vojinvukcevic/ohmsprint-energy-meter-pcb/bom/OhmSprint_V1_BOM.csv

Reference | Qty | Value | Exclude from BOM | Datasheet | MANUFACTURER | Manufacturer Product Number
C1,C4 | 2 | 100uF |  | https://www.digikey.com/en/products/detail/w%C3%BCrth-elektronik/860040573004/5727450 | Würth Elektronik | 860040573004
C2,C3,C21,C22,C25 | 5 | 1uF |  | https://www.digikey.com/en/products/detail/samsung-electro-mechanics/CL21B105KAFNNNE/3886724 | Samsung Electro-Mechanics | CL21B105KAFNNNE
C5,C6,C14,C15 | 4 | 33nF |  | https://www.digikey.com/en/products/detail/tdk/C2012C0G1H333J125AA/2732958 | TDK | C2012C0G1H333J125AA
C7,C9,C10,C12,C13,C16,C17,C18,C23,C27 | 10 | 0.1uF |  | https://www.digikey.com/en/products/detail/kemet/C0805C104K5RACTU/411169 | KEMET | C0805C104K5RACTU
C8,C19,C26 | 3 | 10uF |  | https://www.digikey.com/en/products/detail/samsung-electro-mechanics/CL21A106KOQNNNE/3886754 | Samsung Electro-Mechanics | CL21A106KOQNNNE
C11,C20 | 2 | 10nF |  | https://www.digikey.com/en/products/detail/kemet/C0805C103K5RACTU/411157 | KEMET | C0805C103K5RACTU
C24 | 1 | 220uF |  | https://www.digikey.com/en/products/detail/rubycon/25YXJ220M6-3X11/3563124 | Rubycon | 25YXJ220M6.3X11
D1 | 1 | 1N4007 |  | https://www.digikey.com/en/products/detail/mcc-micro-commercial-components/1n4007-tp/773644 | MCC (Micro Commercial Components) | 1N4007-TP
D2,D3,D4,D5 | 4 | LED |  | https://www.digikey.com/en/products/detail/xinglight/XL-2012UGC/25673312 | XINGLIGHT | XL-2012UGC
FB1 | 1 | 120R |  | https://www.digikey.com/en/products/detail/laird-signal-integrity-products/LI0805H121R-10/806621 | Laird-Signal Integrity Products | LI0805H121R-10
J1 | 1 | PJ-002AH-SMT-TR |  | https://www.digikey.com/en/products/detail/same-sky-formerly-cui-devices/PJ-002AH-SMT-TR/408452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 | Same Sky (Formerly CUI Devices) | PJ-002AH-SMT-TR
J2 | 1 | SJ-3523-SMT-TR |  | https://www.digikey.com/en/products/detail/same-sky-formerly-cui-devices/SJ-3523-SMT-TR/281297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 | Same Sky (Formerly CUI Devices) | SJ-3523-SMT-TR
J3 | 1 | USB4105-GF-A |  | https://www.digikey.com/en/products/detail/gct/USB4105-GF-A/11198441 | GCT | USB4105-GF-A
R1,R3 | 2 | 2R4 |  | https://www.digikey.com/en/products/detail/panasonic-industry/ERJ-6GEYJ2R4V/282163 | Panasonic Industry | ERJ-6GEYJ2R4V
R2,R4,R6,R7,R17 | 5 | 1K |  | https://www.digikey.com/en/products/detail/vishay-dale/CRCW08051K00FKEA/1175637 | Vishay Dale | CRCW08051K00FKEA
R8 | 1 | 25K |  | https://www.digikey.com/en/products/detail/te-connectivity-passive-product/CPF0805B25KE1/2385271 | TE Connectivity Passive Product | CPF0805B25KE1
R9 | 1 | 51R |  | https://www.digikey.com/en/products/detail/panasonic-industry/ERJ-P06F51R0V/9811850 | Panasonic Industry | ERJ-P06F51R0V
R10,R11 | 2 | 510R |  | https://www.digikey.com/en/products/detail/panasonic-industry/ERJ-3GEYJ511V/104634 | Panasonic Industry | ERJ-3GEYJ511V
R12,R16,R20,R21 | 4 | 10K |  | https://www.digikey.com/en/products/detail/yageo/RT0805BRD0710KL/1075550 | YAGEO | RT0805BRD0710KL
R13,R14 | 2 | 22R |  | https://www.digikey.com/en/products/detail/vishay-dale/CRCW080522R0FKEA/1175445 | Vishay Dale | CRCW080522R0FKEA
R15 | 1 | 1K5 |  | https://www.digikey.com/en/products/detail/yageo/RC0805FR-071K5L/727496 | YAGEO | RC0805FR-071K5L
R18,R19 | 2 | 5K1 |  | https://www.digikey.com/en/products/detail/koa-speer-electronics-inc/RK73B2ATTD512J/10236505 | KOA Speer Electronics, Inc. | RK73B2ATTD512J
SW1,SW2,SW3,SW4,SW5 | 5 | SW_Nidec_CAS-120A1 |  | https://www.digikey.com/en/products/detail/e-switch/EG1218/101726 | E-Switch | EG1218
U1 | 1 | ATM90E26-YU-R |  | https://www.digikey.com/en/products/detail/microchip-technology/ATM90E26-YU-R/4899918 | Microchip Technology | ATM90E26-YU-R
U2 | 1 | STM32F373CCTx |  | https://www.digikey.com/en/products/detail/stmicroelectronics/STM32F373CCT6/3648271 | STMicroelectronics | STM32F373CCT6
U3 | 1 | USBLC6-2SC6 |  | https://www.digikey.com/en/products/detail/stmicroelectronics/USBLC6-2SC6/1040559 | STMicroelectronics | USBLC6-2SC6
U4 | 1 | AP2213M-3.3TRG1 |  | https://www.digikey.com/en/products/detail/diodes-incorporated/AP2213M-3-3TRG1/5305740 | Diodes Incorporated | AP2213M-3.3TRG1
U5 | 1 | BM70BLES1FC2-0B03AA |  | https://www.digikey.com/en/products/detail/microchip-technology/BM70BLES1FC2-0B03AA/6623469 | Microchip Technology | BM70BLES1FC2-0B03AA
Y1 | 1 | 8.192MHz |  | https://www.digikey.com/en/products/detail/txc-corporation/AA-8-192MAGE-T/3454735 | TXC CORPORATION | AA-8.192MAGE-T
