vojinvukcevic/ohmsprint-energy-meter-pcb/kicad/3D_models/CL21A106KOQNNNE.step

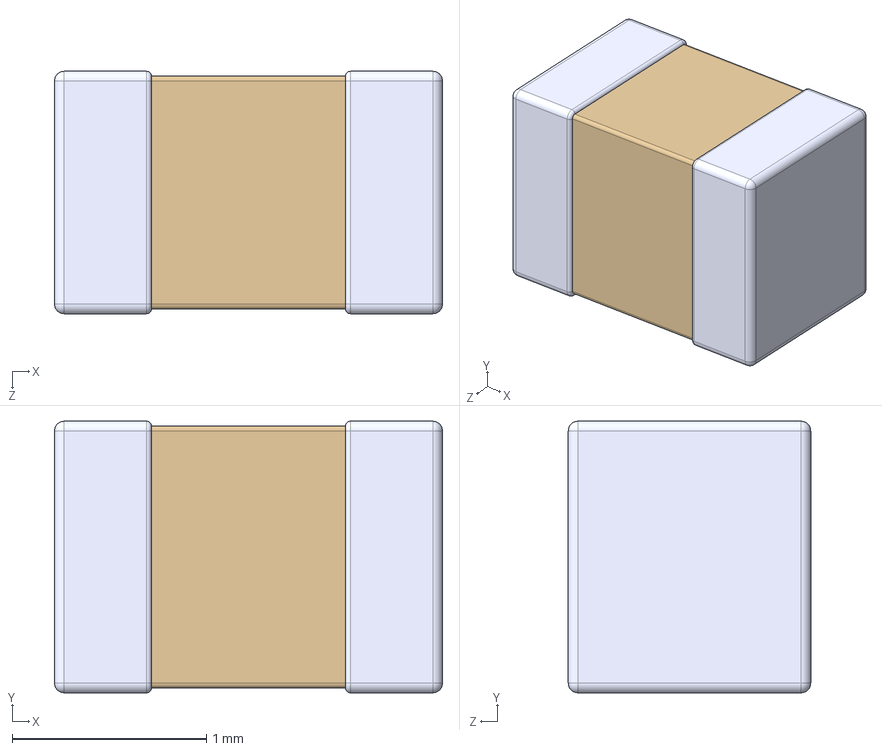
[picture p3: CAD file, 2026-10-12]
kicad/3D_models/CL21A106KOQNNNE.step
2.00 x 1.40 x 1.25 mm
