vojinvukcevic/ohmsprint-energy-meter-pcb/kicad/3D_models/AA-8.192MAGE-T.step

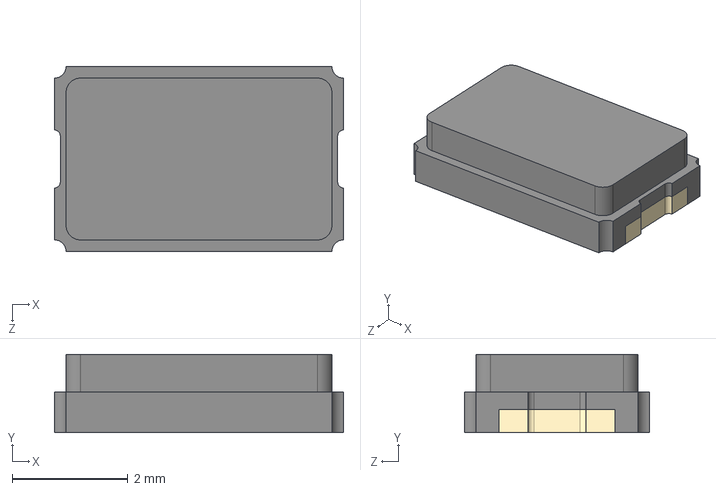
[picture p4: CAD file, 2026-10-12]
kicad/3D_models/AA-8.192MAGE-T.step
5.00 x 1.35 x 3.20 mm
