vojinvukcevic/ohmsprint-energy-meter-pcb/kicad/3D_models/C2012C0G1H333J125AA.step

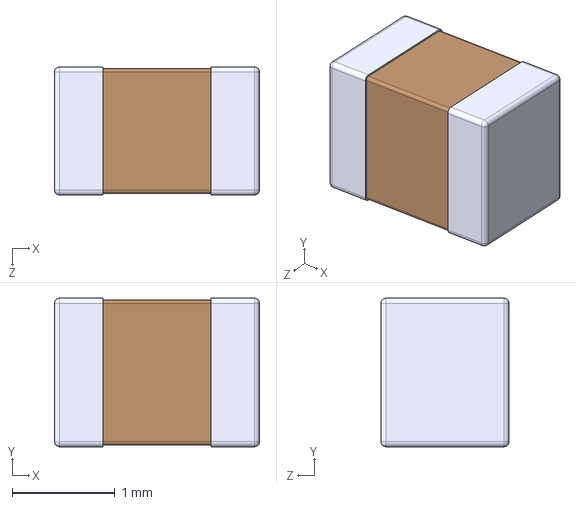
[picture p5: CAD file, 2026-10-12]
kicad/3D_models/C2012C0G1H333J125AA.step
2.00 x 1.45 x 1.25 mm
