vojinvukcevic/ohmsprint-energy-meter-pcb/kicad/3D_models/C0805C103K5RACTU.step

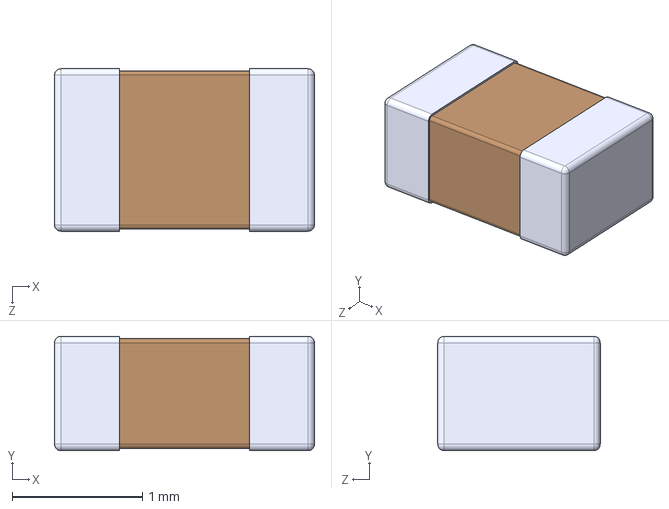
[picture p6: CAD file, 2026-10-12]
kicad/3D_models/C0805C103K5RACTU.step
2.00 x 0.88 x 1.25 mm
