vojinvukcevic/ohmsprint-energy-meter-pcb/kicad/3D_models/SSOP28_10P3X5P4_MCH.step

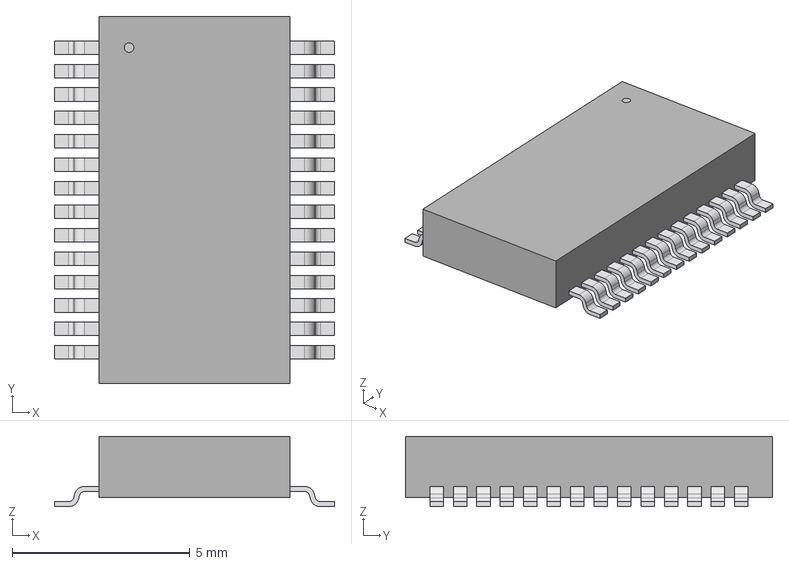
[picture p7: CAD file, 2026-10-12]
kicad/3D_models/SSOP28_10P3X5P4_MCH.step
7.90 x 10.3 x 1.98 mm
