vojinvukcevic/ohmsprint-energy-meter-pcb/kicad/3D_models/SOIC-8_DIO.step

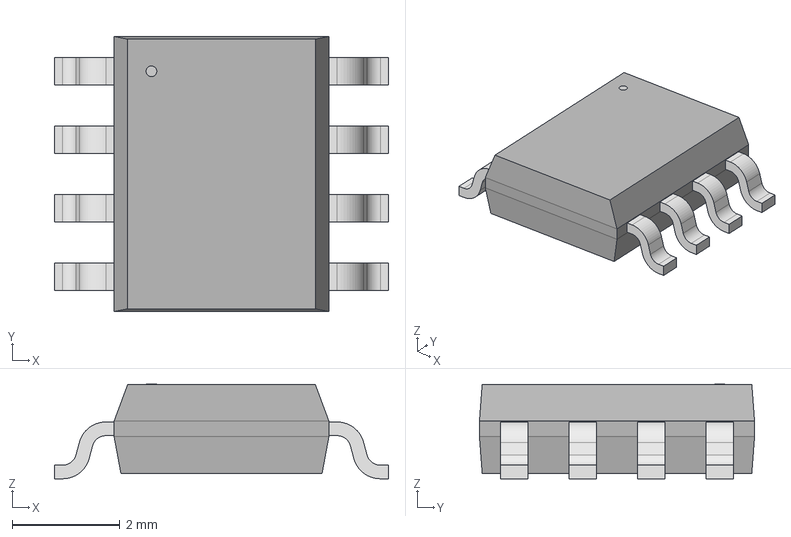
[picture p8: CAD file, 2026-10-12]
kicad/3D_models/SOIC-8_DIO.step
6.20 x 5.11 x 1.75 mm
