vojinvukcevic/ohmsprint-energy-meter-pcb/(list of files, cad)

Other CAD files:
kicad/3D_models/C0805C104K5RACTU.step
