vojinvukcevic/ohmsprint-energy-meter-pcb/docs/OhmSprint_V1_schematic.pdf

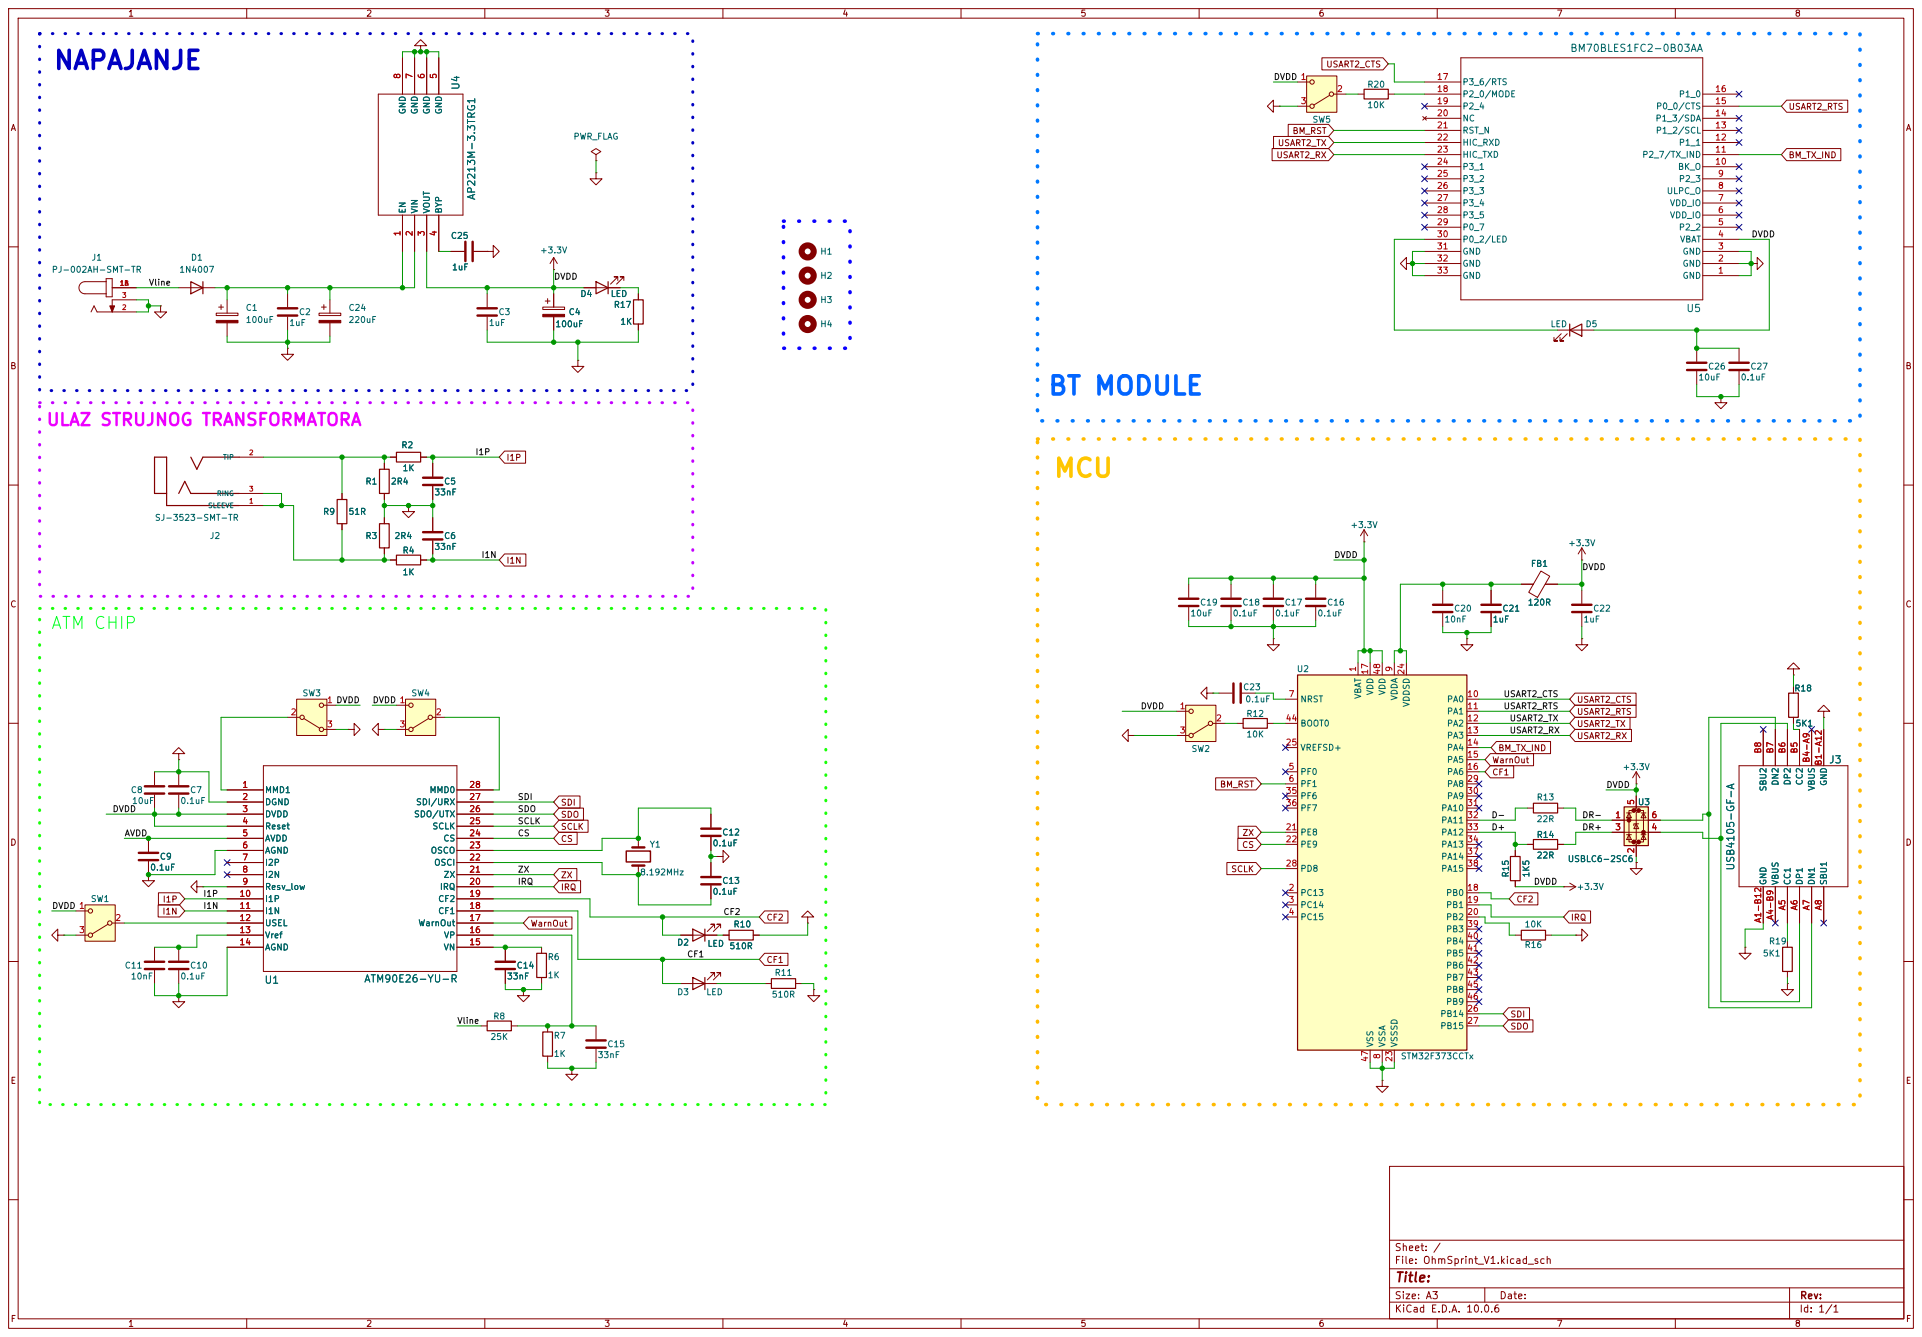
[picture p9: page 1]

Size: A3 | Rev: | F Date:
KiCad E.D.A. 10.0.6 | Id: 1/1
