vojinvukcevic/ohmsprint-energy-meter-pcb/kicad/OhmSprint_V1.kicad_pcb

## KiCad design kicad/OhmSprint_V1.kicad_pcb (2026-10-12)

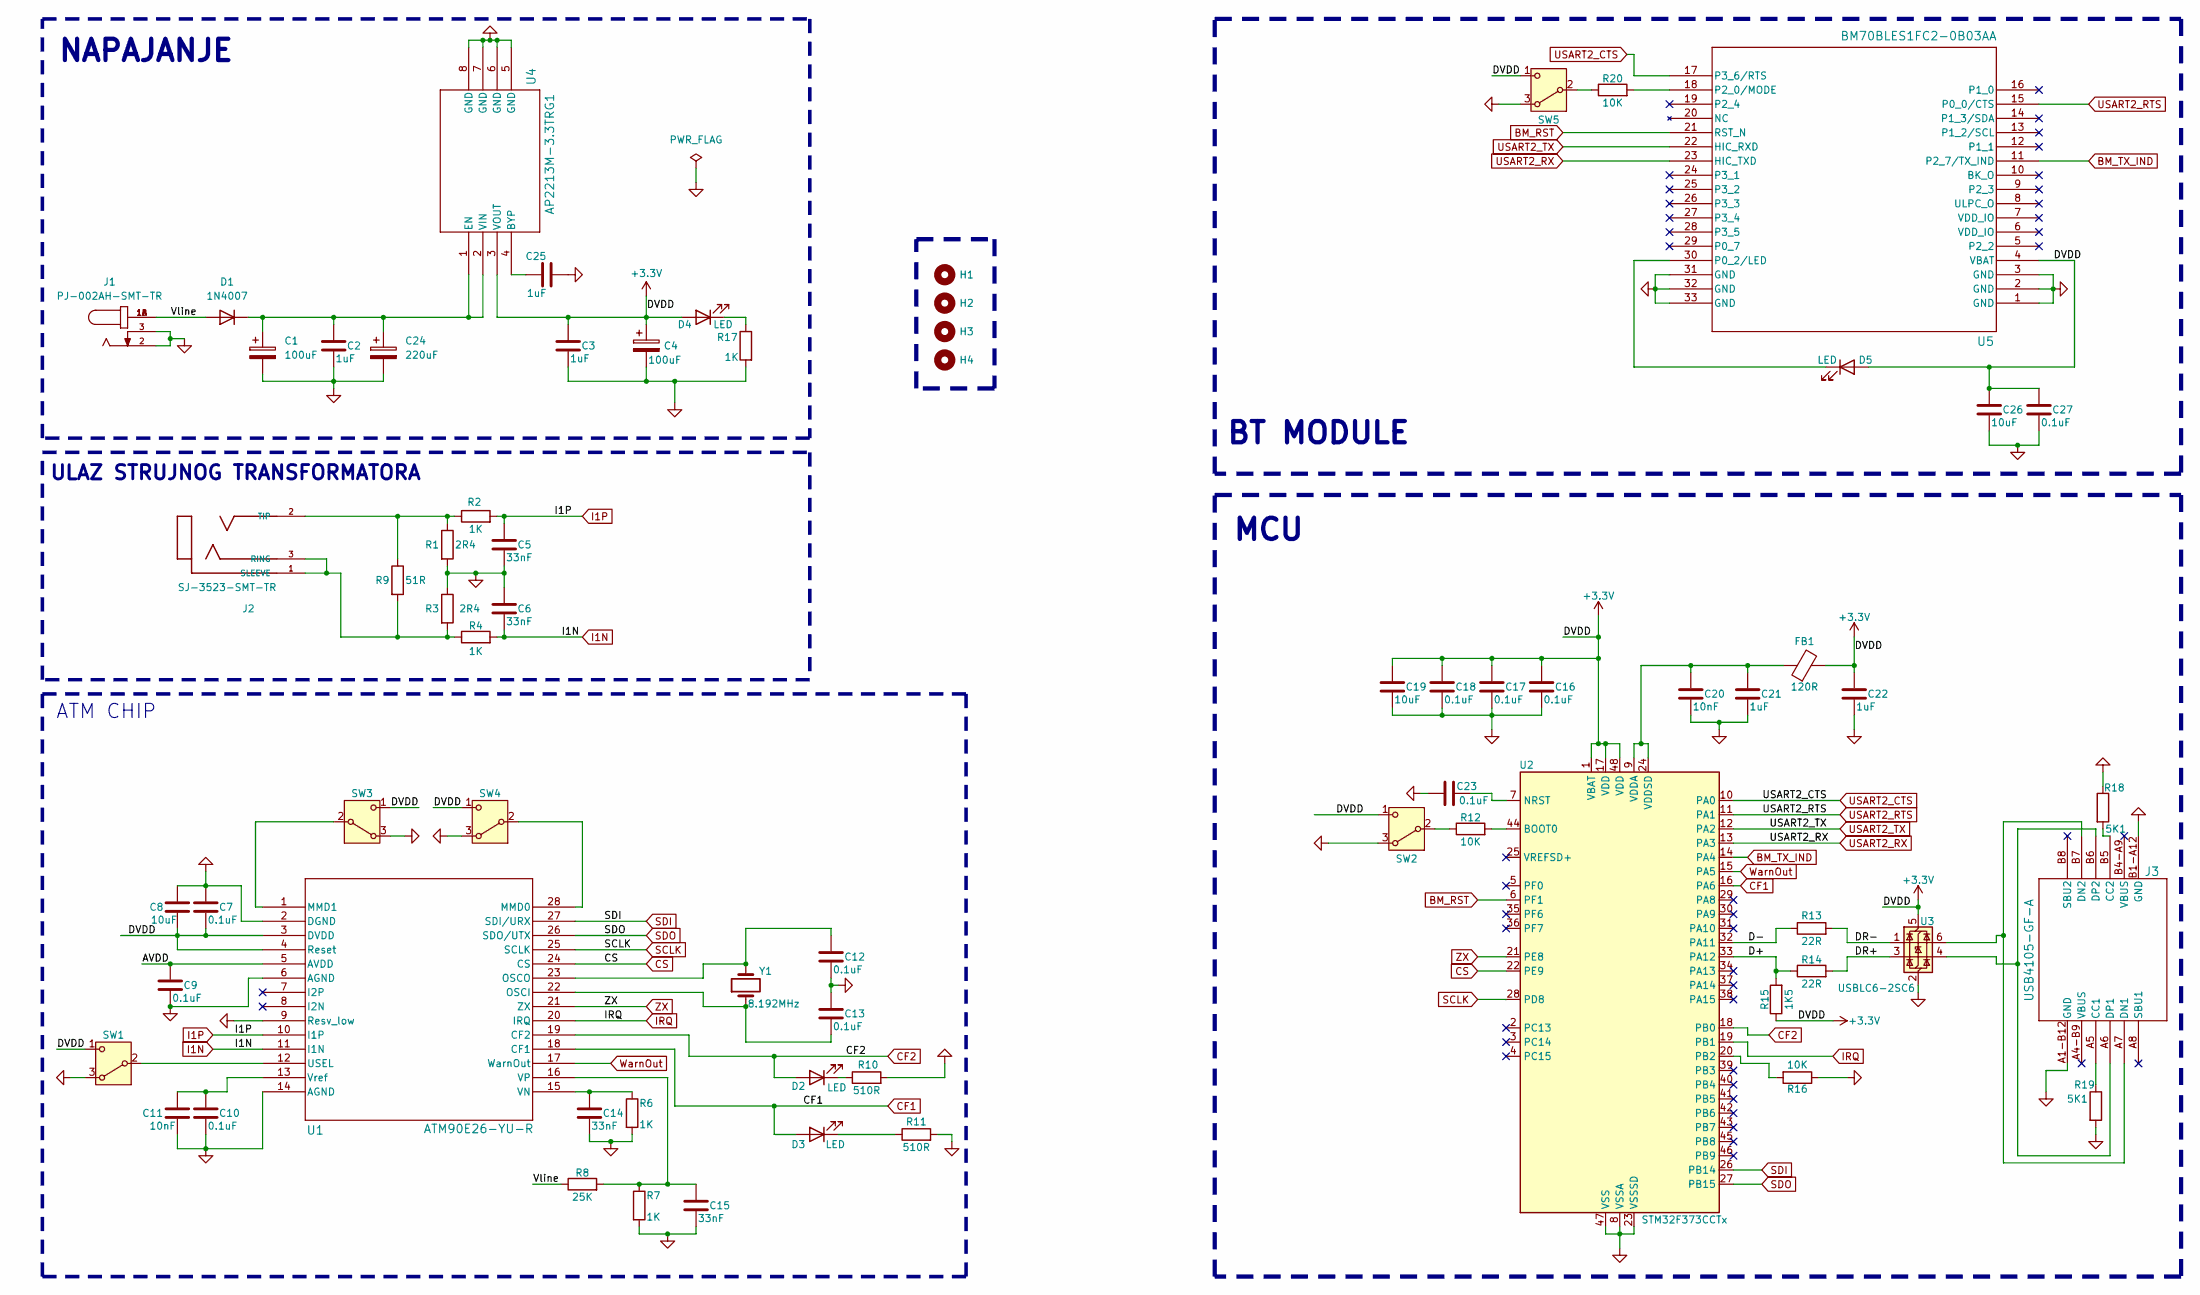
[picture p10: schematic OhmSprint_V1.kicad_sch]

Parts:
C1, C4: 100uF; 100uF_Polarized_Cap
C2, C3, C21, C22, C25: 1uF; 1uF_Cap
C5, C6, C14, C15: 33nF; 33nF_Cap
C7, C9, C10, C12, C13, C16, C17, C18, C23, C27: 0.1uF; 0.1uF_Cap
C8, C19, C26: 10uF; 10uF_Cap
C11: 10nF; 10nF_Cap
C20: 10nF; 10uF_Cap
C24: 220uF; 220uF_Polarized_Cap
D1: 1N4007; DIO_N4007-T_DIO
D2, D3, D4, D5: LED; LED_0805_2012Metric
FB1: 120R; FB_LI0805H121R-10
H1, H2, H3, H4: MountingHole; MountingHole_2.1mm
J1: PJ-002AH-SMT-TR; CUI_PJ-002AH-SMT-TR
J2: SJ-3523-SMT-TR; CUI_SJ-3523-SMT-TR
J3: USB4105-GF-A; USB4105_GCT
R1, R3: 2R4; 2R4_Resistor
R2, R4, R6, R7, R17: 1K; 1K_Resistor
R8: 25K; 25K_Resistor
R9: 51R; 51R_Resistor
R10, R11: 510R; 510R_Resistor
R12, R20: 10K; 10K_Resistor
R13, R14: 22R; 22R_Resistor
R15: 1K5; 1K5_Resistor
R16: 10K; 1K5_Resistor
R18, R19: 5K1; 5K1_Resistor
SW1, SW2, SW3, SW4, SW5: SW_Nidec_CAS-120A1; SW_EG1218
U1: ATM90E26-YU-R; ATM90E26
U2: STM32F373CCTx; STM32F373CCT6
U3: USBLC6-2SC6; USBLC6-25C6
U4: AP2213M-3.3TRG1
U5: BM70BLES1FC2-0B03AA; BM70BLES1FC2_MCH
Y1: 8.192MHz; CRYSTAL-AA-8.192MAGE

Connections:
+3.3V: C3.1, C4.1, C7.2, C8.2, C16.1, C17.1, C18.1, C19.1, C22.1, C26.1, C27.1, D4.2 (A), D5.2 (A), FB1.2, R15.1, SW1.1 (C), SW2.1 (C), SW3.1 (C), SW4.1 (C), SW5.1 (C), U1.3 (DVDD), U1.4 (Reset), U2.1 (VBAT), U2.17 (VDD), U2.48 (VDD), U3.5 (VBUS), U4.3 (VOUT), U5.4 (VBAT)
/AVDD: C9.1, U1.5 (AVDD)
/D+: R14.1, R15.2, U2.33 (PA12)
/D-: R13.1, U2.32 (PA11)
/DR+: R14.2, U3.3 (I/O2)
/DR-: R13.2, U3.1 (I/O1)
/Vline: D1.2 (A), J1.1A, J1.1B, R8.1
BM_RST: U2.6 (PF1), U5.21 (RST_N)
BM_TX_IND: U2.14 (PA4), U5.11 (P2_7/TX_IND)
CF1: D3.2 (A), U1.18 (CF1), U2.16 (PA6)
CF2: D2.2 (A), U1.19 (CF2), U2.18 (PB0)
CS: U1.24 (CS), U2.22 (PE9)
GND: C1.2, C2.2, C3.2, C4.2, C5.2, C6.1, C7.1, C8.1, C9.2, C10.2, C11.2, C12.2, C13.1, C14.2, C15.2, C16.2, C17.2, C18.2, C19.2, C20.2, C21.2, C22.2, C23.1, C24.2, C25.2, C26.2, C27.2, J1.2, J1.3, J3.A1-B12 (GND), J3.B1-A12 (GND), R1.2, R3.1, R6.2, R7.2, R10.2, R11.2, R16.1, R17.2, R18.1, R19.2, SW1.3 (A), SW2.3 (A), SW3.3 (A), SW4.3 (A), SW5.3 (A), U1.2 (DGND), U1.6 (AGND), U1.9 (Resv_low), U1.14 (AGND), U2.8 (VSSA), U2.23 (VSSSD), U2.47 (VSS), U3.2 (GND), U4.5 (GND), U4.6 (GND), U4.7 (GND), U4.8 (GND), U5.1 (GND), U5.2 (GND), U5.3 (GND), U5.31 (GND), U5.32 (GND), U5.33 (GND)
I1N: C6.2, R4.2, U1.11 (I1N)
I1P: C5.1, R2.2, U1.10 (I1P)
IRQ: U1.20 (IRQ), U2.19 (PB1)
unnamed: C1.1, C2.1, C24.1, D1.1 (K), U4.1 (EN), U4.2 (VIN)
unnamed: D2.1 (K), R10.1
unnamed: D3.1 (K), R11.1
unnamed: D4.1 (K), R17.1
unnamed: D5.1 (K), U5.30 (P0_2/LED)
unnamed: J2.1 (SLEEVE), J2.3 (RING), R3.2, R4.1, R9.2
unnamed: J2.2 (TIP), R1.1, R2.1, R9.1
unnamed: J3.A5 (CC1), R19.1
unnamed: J3.B5 (CC2), R18.2
unnamed: J3.A7 (DN1), J3.B7 (DN2), U3.6 (I/O1)
unnamed: J3.A6 (DP1), J3.B6 (DP2), U3.4 (I/O2)
unnamed: SW1.2 (B), U1.12 (USEL)
unnamed: R12.1, SW2.2 (B)
unnamed: SW3.2 (B), U1.1 (MMD1)
unnamed: SW4.2 (B), U1.28 (MMD0)
unnamed: R20.1, SW5.2 (B)
unnamed: C13.2, U1.22 (OSCI), Y1.1
unnamed: C12.1, U1.23 (OSCO), Y1.2
unnamed: C14.1, R6.1, U1.15 (VN)
unnamed: C15.1, R7.1, R8.2, U1.16 (VP)
unnamed: C10.1, C11.1, U1.13 (Vref)
unnamed: R12.2, U2.44 (BOOT0)
unnamed: C23.2, U2.7 (NRST)
unnamed: R16.2, U2.20 (PB2)
unnamed: C20.1, C21.1, FB1.1, U2.9 (VDDA), U2.24 (VDDSD)
unnamed: C25.1, U4.4 (BYP)
unnamed: R20.2, U5.18 (P2_0/MODE)
SCLK: U1.25 (SCLK), U2.28 (PD8)
SDI: U1.27 (SDI/URX), U2.26 (PB14)
SDO: U1.26 (SDO/UTX), U2.27 (PB15)
USART2_CTS: U2.10 (PA0), U5.17 (P3_6/RTS)
USART2_RTS: U2.11 (PA1), U5.15 (P0_0/CTS)
USART2_RX: U2.13 (PA3), U5.23 (HIC_TXD)
USART2_TX: U2.12 (PA2), U5.22 (HIC_RXD)
WarnOut: U1.17 (WarnOut), U2.15 (PA5)
ZX: U1.21 (ZX), U2.21 (PE8)

Notes on the sheet:
NAPAJANJE
ATM CHIP
BT MODULE
ULAZ STRUJNOG TRANSFORMATORA
MCU

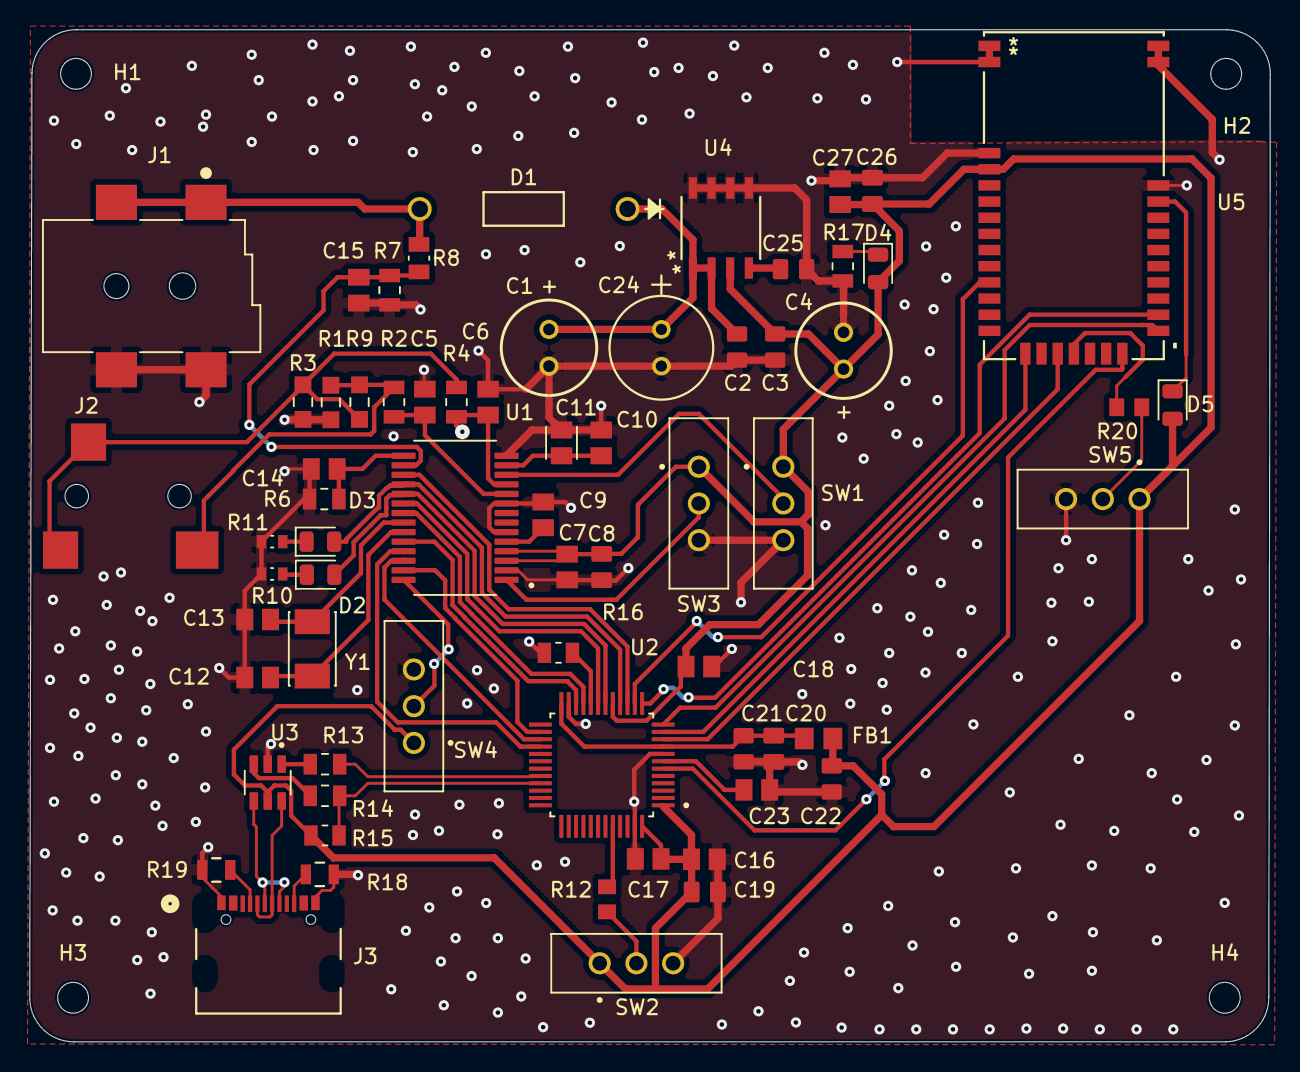
[picture p11: board OhmSprint_V1.kicad_pcb from above]

Board: 2 copper layers, 84.4 x 68.9 mm, 70 parts (0 on the bottom side), 52 nets.
