vojinvukcevic/ohmsprint-energy-meter-pcb/(commit log)

2026-10-12 Add KiCad 10 project: schematic, PCB, symbols, footprints and 3D models
2026-10-12 Add fabrication outputs (Gerbers, drill files) and BOM
2026-10-12 Add README, schematic PDF and board images
